FlyingDomotic/Railway-turntable/data/imagePont.png

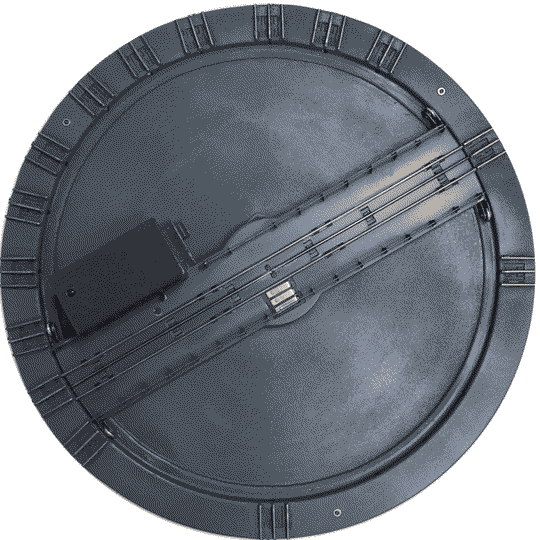
data/imagePont.png
