FlyingDomotic/Railway-turntable/data/plaque.png

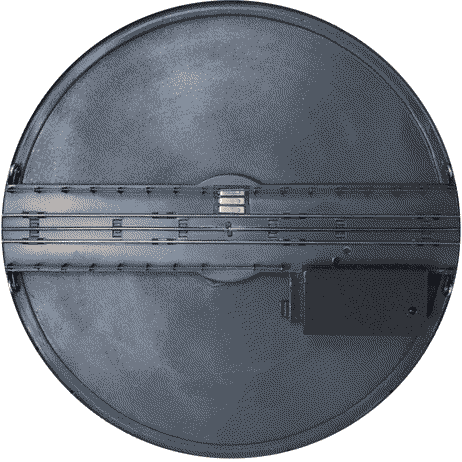
data/plaque.png
