FlyingDomotic/Railway-turntable/Schema.jpg

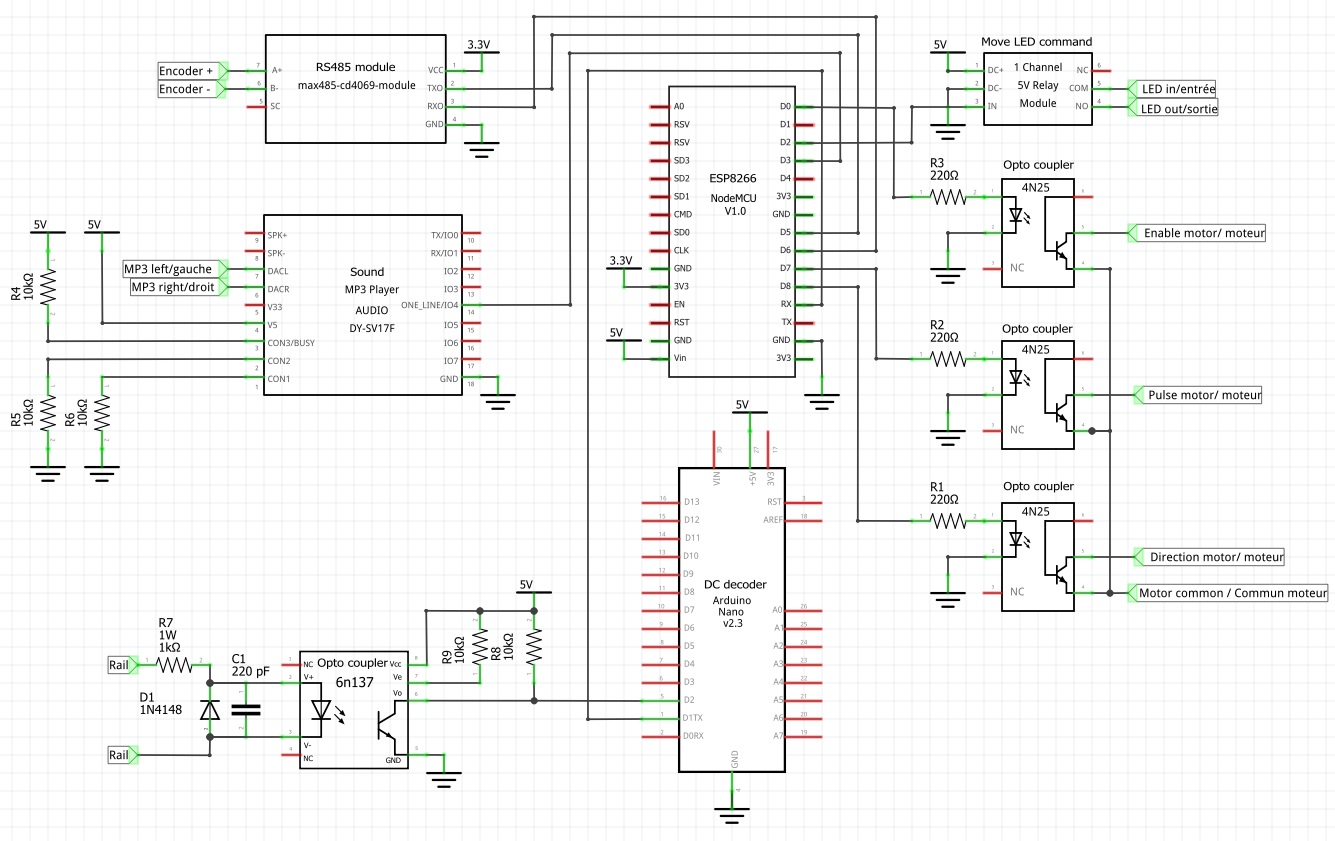
Schema.jpg
