FlyingDomotic/Railway-turntable/src/PontTournant.ino

#define VERSION "24.11.26-1"
/*
 *	   English: Railway turntable control
 *	   Français : Contrôle d'un pont tournant ferroviaire miniature
 *
 *	Hardware
 *		ESP8266
 *		Stepper with driver (enable/pulse/direction) (for example NEMA 24 with DM556T)
 *		RS485 aboslute encoder (for example QY3806-485RTU)
 *		Serial/RS485 adapter
 *		DF-SV17A MP3 player (optional)
 *		Rotation LED (optional)
 *      DCC decoder (optional)
 *
 *	Matériel
 *		ESP8266
 *		Moteur pas à pas avec driver (enable/pulse/direction) (par exemple NEMA 24 avec DM556T)
 *		Encodeur absolu RS485 (par exemple QY3806-485RTU)
 *		Adaptateur série/RS485
 *		Lecteur MP3 DF-SV17A (optionnel)
 *		LED de rotation (optionnel)
 *      Décodeur DCC (optionnel)
 *
 *	Connections
 *		By default, the following pins are defined in preference.h file:
 *          RX (Serial): DCC decoder TX pin
 *			D0 (enablePin): Stepper enable signal
 *			D2 (runPin): Rotation in progress LED pin
 *			D3 (mp3Pin): MP3 one-line pin
 *			D5 (rxPin): RS485 RX pin
 *			D6 (txPin): RS485 TX pin
 *			D7 (pulsePin): Stepper pulse signal
 * 			D8 (directionPin): Stepper direction signal
 *
 *	Connexions
 *		Par défaut, les pinoches suivantes sont définies dans le fichier preference.h :
 *          RX (Serial): Pinoche TX du decoder DCC
 *			D0 (enablePin) : Signal enable du moteur
 *			D2 (runPin) : Pinoche de la LED d'indication de rotation
 *			D3 (mp3Pin) : Pinoche du module MP3 DF-SV17A
 *			D5 (rxPin) : RX du module RS485
 *			D6 (txPin) : TX du module RS485
 *			D7 (pulsePin) : Signal pulse du moteur
 * 			D8 (directionPin) : Signal direction du moteur
 *
 *	Available URL
 *		/			Root page (displays turntable allowing clicking on tracks)
 *		/status		Returns status in JSON format
 *		/goto/<nnn>	Rurns turntable in front of track <nnn> (can be negative to flip direction)
 *		/setup		Display setup page
 *		/edit		Manage and edit flie system
 *		/settings	Returns settings in JSON format
 *		/tstsnd/<x>	Test sound <x>, with 1=before rotation, 2=during rotation and 3=after rotation
 *		/debug		Display internal variables to debug
 *
 * 	URL disponibles
 *		/			Page d'accueil (affiche le pont et permet de cliquer sur les voies)
 *		/status		Retourne l'état sous forme JSON
 *		/goto/<nnn>	Tourne le pont en face de la voie <nnn> (négatif pour retourner la loco)
 *		/setup		Affiche la page de configuration
 *		/edit		Gère et édite le système de fichier
 *		/settings	Retourne la configuration au format JSON
 *		/tstsnd/<x>	Testele son <x>, 1=avant rotation, 2=pendant rotation and 3=après rotation
 *		/debug		Affiche les variables internes pour déverminer
 *
 *	Flying Domotic - Juillet 2024 - For Fablab/Pour le FabLab
 *
 *	GNU GENERAL PUBLIC LICENSE - Version 3, 29 June 2007
 *
 */

#include <ESP8266WiFi.h>											// Wifi
#include <ESPAsyncWebServer.h>										// Asynchronous web server
#include <ArduinoOTA.h>												// OTA (network update)
#include <arduino.h>												// Arduino
#include <preferences.h>											// Turn table preferences
#include <stepperCommand.h>											// Stepper
#include <rotationSensor.h>											// Encoder
#include <mp3_player_module_wire.h>									// DFPlayer mini MP3 player
#include <cmath>													// Math functions
#include <LittleFS.h>												// Flash dile system
#include <littleFsEditor.h>											// LittleFS file system editor
#include <ArduinoJson.h>											// JSON documents

//	---- Variables ----

//	Asynchronous web server
AsyncWebServer webServer(80);										// Web server on port 80
AsyncEventSource events("/events");									// Event root

//	Wifi and module names
String ssid;
String pwd;
String espName = "PontTournant";

//	Preferences file name
#define SETTINGS_FILE "settings.json"

//	Stepper
StepperCommand
	stepper(pulsePin, directionPin, enablePin, traceDebug);			// Setpper class
float lastAngleSent = 0;											// Last sent angle
float currentAngle = 0;												// Current angle
float requiredAngle = -1;											// Required angle
unsigned long rotationStartTime = 0;								// Time of rotation start
unsigned long microStepsToGo = 0;									// Remaining micro steps to send
unsigned long inertiaStepsStarting = 0;								// Number of steps corresponding to inertiaAngleStarting
unsigned long inertiaEndStarting = 0;								// Number of step of end of starting steps (total steps - inertiaStepsStarting)
float normalStepDuration = 0.0;										// Normal (full speed) step duration
float currentStepDuration = 0.0;									// Current (variable) step duration
float inertiaInitialStepDuration = 0.0;								// Duration of step when starting
float inertiaDurationDecrement = 0.0;								// Step duration decrement to add each steps when starting
unsigned long inertiaStepsStopping = 0;								// Number of steps corresponding to inertiaAngleStopping
float inertiaDurationIncrement = 0.0;								// Step duration increment to add each steps when stopping
float inertiaFinalStepDuration = 0.0;								// Duration of step when stopping (will also be used to fix position)
enum stepperState {													// Rotation states
	stepperStopped,
	stepperStarting,
	stepperRunning,
	stepperStopping,
	stepperFixing,
	testingSound
};
stepperState rotationState = stepperStopped;			// Rotation current state
#define MIN_DELTA_ANGLE 0.02							// Minimum delta before sending angle change
const char stepperStateText0[] PROGMEM = "Stopped";
const char stepperStateText1[] PROGMEM = "Starting";
const char stepperStateText2[] PROGMEM = "Running";
const char stepperStateText3[] PROGMEM = "Stopping";
const char stepperStateText4[] PROGMEM = "Fixing";
const char stepperStateText5[] PROGMEM = "TestingSound";
const char *const stepperStateTable[] PROGMEM = {stepperStateText0, stepperStateText1, stepperStateText2, stepperStateText3, stepperStateText4, stepperStateText5};

//	Encoder
RotationSensor encoder(rxPin, txPin, traceDebug);		// Encoder class
uint16_t resultValue;									// Encoder last result
unsigned long resultValueTime = 0;						// Encoder last result time
bool encoderReading = false;							// Is encoder reading?
unsigned long encoderReadTime = 0;						// Save encoder read time
Modbus::ResultCode encoderLastReadError;				// Last error returned by encoder

// MP3 reader
Mp3PlayerModuleWire mp3Player(mp3Pin);					// MP3 module one-line protocol
unsigned long playerStartedTime = 0;					// Last play time
unsigned long playerDuration = 0;						// Play duration time

// DCC decoder
uint16_t lastDccAddress = 0;                            // Last DCC address received
char dccBuffer[15];                                     // Buffer for DCC message xxxxx,xxx,xxx
uint8_t dccBufferPtr = 0;                               // Pointer into DCC buffer

//	---- Print rountines ----

static void printInfo(const char* _format, ...) {
	// Make the message
	char msg[512];                              		// Message buffer (message truncated if longer than this)
	va_list arguments;                                  // Variable argument list
	va_start(arguments, _format);                       // Read arguments after _format
	vsnprintf_P(msg, sizeof(msg), _format, arguments);	// Return buffer containing requested format with given arguments
	va_end(arguments);                                  // End of argument list
	Serial.print(msg);			                        // Print on SERIAL_PORT
	if (traceCode) {
		events.send(msg, "info");						// Send message to destination
	}
}

static void printError(const char* _format, ...) {
	// Make the message
	char msg[512];                              		// Message buffer (message truncated if longer than this)
	va_list arguments;                                  // Variable argument list
	va_start(arguments, _format);                       // Read arguments after _format
	vsnprintf_P(msg, sizeof(msg), _format, arguments);	// Return buffer containing requested format with given arguments
	va_end(arguments);                                  // End of argument list
	Serial.print(msg);			                        // Print on SERIAL_PORT
	events.send(msg, "error");							// Send message to destination
}

//	---- Preferences routines ----

// Dumps all settings on screen
void dumpSettings(void) {
	printInfo("ssid = %s\n", ssid.c_str());
	printInfo("pwd = %s\n", pwd.c_str());
	printInfo("name = %s\n", espName.c_str());
	printInfo("degreesPerStep = %.2f\n", degreesPerStep);
	printInfo("microStepsPerStep = %d\n", microStepsPerStep);
	printInfo("invertStepper = %s\n", invertStepper ? "false" : "true");
	printInfo("stepperReduction = %.2f\n", stepperReduction);
	printInfo("requiredRMP = %.2f\n", requiredRPM);
	printInfo("driverMinimalMicroSec = %d\n", driverMinimalMicroSec);
	printInfo("inertiaAngleStarting = %.2f\n", inertiaAngleStarting);
	printInfo("inertiaAngleStopping = %.2f\n", inertiaAngleStopping);
	printInfo("inertiaFactorStarting = %.2f\n", inertiaFactorStarting);
	printInfo("inertiaFactorStopping = %.2f\n", inertiaFactorStopping);
    printInfo("ledOnWhenHigh = %s\n", ledOnWhenHigh ? "true" : "false");
	printInfo("maxDelta = %d\n", maxDelta);
	printInfo("encoderOffsetAngle = %.2f\n", encoderOffsetAngle);
	printInfo("clockwiseIncrement = %s\n", clockwiseIncrement ? "true" : "false");
	printInfo("imageOffsetAngle = %.2f\n", imageOffsetAngle);
	printInfo("enableCircles = %s\n", enableCircles ? "true" : "false");
	printInfo("slaveId = %d\n", slaveId);
	printInfo("regId = %d\n", regId);
	printInfo("radius = %f\n", radius);
	printInfo("enableSound = %s\n", enableSound ? "true" : "false");
	printInfo("beforeSoundIndex = %d\n", beforeSoundIndex);
	printInfo("beforeSoundDuration = %.2f\n", beforeSoundDuration);
	printInfo("beforeSoundVolume = %d\n", beforeSoundVolume);
	printInfo("moveSoundIndex = %d\n", moveSoundIndex);
	printInfo("moveSoundVolume = %d\n", moveSoundVolume);
	printInfo("afterSoundIndex = %d\n", afterSoundIndex);
	printInfo("afterSoundDuration = %.2f\n", afterSoundDuration);
	printInfo("afterSoundVolume = %d\n", afterSoundVolume);
	printInfo("enableDCC = %s\n", enableDCC ? "true" : "false");
    printInfo("enableReversePosition = %s\n", enableReversePosition ? "true" : "false");
	printInfo("trackCount = %d\n", trackCount);
	printInfo("traceDebug = %s\n", traceDebug ? "true" : "false");
	printInfo("traceCode = %s\n", traceCode ? "true" : "false");
	printInfo("traceJava = %s\n", traceJava ? "true" : "false");

	// Dump all defined angles
	for (uint8_t i = 1; i <= POSITION_COUNT; i++) {
		if (indexes[i] != -1) {
			printInfo("a%d=%.2f", i, indexes[i]);
            // Print DCC addresses if enabled
            if (enableDCC) {
                   printInfo("/%.1f", addresses[i]);
                    if (enableReversePosition) {
                        printInfo("/%.1f", reverses[i]);
                    }
            }
            printInfo(" ");
		}
	}
	printInfo("\n");
}

// Read settings
bool readSettings(void) {
	File settingsFile = LittleFS.open(SETTINGS_FILE, "r");			// Open settings file
	if (!settingsFile) {											// Error opening?
		printError("Failed to open config file\n");
		return false;
	}

	JsonDocument settings;
	auto error = deserializeJson(settings, settingsFile);			// Read settings
	settingsFile.close();											// Close file
	if (error) {													// Error reading JSON?
		printError("Failed to parse config file\n");
		return false;
	}

	// Load all settings into corresponding variables
	degreesPerStep = settings["degreesPerStep"].as<float>();
	if (degreesPerStep <= 0.0) {
		printError("degreesPerStep is %f, should be > 0\n", degreesPerStep);
	}
	microStepsPerStep = settings["microStepsPerStep"].as<uint16_t>();
	if (microStepsPerStep == 0) {
		printError("microStepsPerStep is %d, should be > 0\n", microStepsPerStep);
	}
	invertStepper = settings["invertStepper"].as<bool>();
	stepperReduction = settings["stepperReduction"].as<float>();
	if (stepperReduction <= 0.0) {
		printError("stepperReduction is %f, should be > 0\n", stepperReduction);
	}
	driverMinimalMicroSec =settings["driverMinimalMicroSec"].as<uint16_t>();
	requiredRPM = settings["requiredRPM"].as<float>();
	if (requiredRPM <= 0.0) {
		printError("requiredRPM is %f, should be > 0\n", requiredRPM);
	}
	inertiaAngleStarting = settings["inertiaAngleStarting"].as<float>();
	if (inertiaAngleStarting < 0.0) {
		printError("inertiaAngleStarting is %f, should be >= 0\n", inertiaAngleStarting);
	}
	inertiaAngleStopping = settings["inertiaAngleStopping"].as<float>();
	if (inertiaAngleStopping < 0.0) {
		printError("inertiaAngleStopping is %f, should be >= 0\n", inertiaAngleStopping);
	}
	inertiaFactorStarting = settings["inertiaFactorStarting"].as<float>();
	if (inertiaFactorStarting < 1.0) {
		printError("inertiaFactorStarting is %f, should be >= 1\n", inertiaFactorStarting);
	}
	inertiaFactorStopping = settings["inertiaFactorStopping"].as<float>();
	if (inertiaFactorStopping < 1.0) {
		printError("inertiaFactorStopping is %f, should be >= 1\n", inertiaFactorStopping);
	}
	maxDelta = settings["maxDelta"].as<uint8_t>();
	enableEncoder = settings["enableEncoder"].as<bool>();
	adjustPosition = settings["adjustPosition"].as<bool>();
	encoderOffsetAngle = settings["encoderOffsetAngle"].as<float>();
	clockwiseIncrement = settings["clockwiseIncrement"].as<bool>();
	imageOffsetAngle = settings["imageOffsetAngle"].as<float>();
	slaveId = settings["slaveId"].as<uint8_t>();
	regId = settings["regId"].as<uint8_t>();
	radius = settings["radius"].as<float>();
	trackCount = settings["trackCount"].as<uint8_t>();
	traceDebug = settings["traceDebug"].as<bool>();
	traceCode = settings["traceCode"].as<bool>();
	traceJava = settings["traceJava"].as<bool>();
    ledOnWhenHigh = settings["ledOnWhenHigh"].as<bool>();
	ssid = settings["ssid"].as<String>();
	pwd = settings["pwd"].as<String>();
	espName = settings["name"].as<String>();
	enableSound = settings["enableSound"].as<bool>();
	enableCircles = settings["enableCircles"].as<bool>();
	enableDCC = settings["enableDCC"].as<bool>();
	enableReversePosition = settings["enableReversePosition"].as<bool>();
	beforeSoundIndex = settings["beforeSoundIndex"].as<uint16_t>();
	beforeSoundDuration = settings["beforeSoundDuration"].as<float>();
	beforeSoundVolume = settings["beforeSoundVolume"].as<uint8_t>();
	moveSoundIndex = settings["moveSoundIndex"].as<uint16_t>();
	moveSoundVolume = settings["moveSoundVolume"].as<uint8_t>();
	afterSoundIndex = settings["afterSoundIndex"].as<uint16_t>();
	afterSoundDuration = settings["afterSoundDuration"].as<float>();
    afterSoundVolume = settings["afterSoundVolume"].as<uint8_t>();

	// Read "axx" and "dxx" variables into a table
	char name[10];
	for (uint8_t i = 1; i <= POSITION_COUNT; i++) {
		snprintf(name, sizeof(name), "a%d", i);
		indexes[i] = settings[name].as<float>();
		snprintf(name, sizeof(name), "d%d", i);
		addresses[i] = settings[name].as<float>();
		snprintf(name, sizeof(name), "r%d", i);
		reverses[i] = settings[name].as<float>();
	}
	// Dump settings on screen
	dumpSettings();
	// Send values to stepper and encoder
	stepper.setParams(degreesPerStep, microStepsPerStep, stepperReduction, invertStepper, driverMinimalMicroSec, requiredRPM, traceDebug);
	encoder.setParams(encoderOffsetAngle, clockwiseIncrement, traceDebug);
	return true;
}

// Write settings
void writeSettings(void) {
	JsonDocument settings;
	char name[10];

	// Load settings in JSON
	settings["ssid"] = ssid.c_str();
	settings["pwd"] = pwd.c_str();
	settings["name"] = espName.c_str();
	settings["degreesPerStep"] = degreesPerStep;
	settings["microStepsPerStep"] = microStepsPerStep;
	settings["driverMinimalMicroSec"] = driverMinimalMicroSec;
	settings["invertStepper"] = invertStepper;
	settings["stepperReduction"] = stepperReduction;
	settings["requiredRPM"] = requiredRPM;
	settings["inertiaAngleStarting"] = inertiaAngleStarting;
	settings["inertiaAngleStopping"] = inertiaAngleStopping;
	settings["inertiaFactorStarting"] = inertiaFactorStarting;
	settings["inertiaFactorStopping"] = inertiaFactorStopping;
    settings["ledOnWhenHigh"] = ledOnWhenHigh;
	settings["maxDelta"] = maxDelta;
	settings["enableEncoder"] = enableEncoder;
	settings["adjustPosition"] = adjustPosition;
	settings["encoderOffsetAngle"] = encoderOffsetAngle;
	settings["clockwiseIncrement"] = clockwiseIncrement;
	settings["imageOffsetAngle"] = imageOffsetAngle;
	settings["slaveId"] = slaveId;
	settings["regId"] = regId;
	settings["radius"] = radius;
	settings["enableDCC"] = enableDCC;
	settings["enableReversePosition"] = enableReversePosition;
	settings["enableSound"] = enableSound;
	settings["beforeSoundIndex"] = beforeSoundIndex;
	settings["beforeSoundDuration"] = beforeSoundDuration;
	settings["beforeSoundVolume"] = beforeSoundVolume;
	settings["moveSoundIndex"] = moveSoundIndex;
	settings["moveSoundVolume"] = moveSoundVolume;
	settings["afterSoundIndex"] = afterSoundIndex;
	settings["afterSoundDuration"] = afterSoundDuration;
	settings["afterSoundVolume"] = afterSoundVolume;
	settings["traceDebug"] = traceDebug;
	settings["traceCode"] = traceCode;
	settings["traceJava"] = traceJava;
	settings["trackCount"] = trackCount;
	// Load all "axx" and "dxx" variables
	for (uint8_t i = 1; i <= POSITION_COUNT; i++) {
		snprintf(name, sizeof(name), "a%d", i);
		settings[name] = indexes[i];
		snprintf(name, sizeof(name), "d%d", i);
		settings[name] = addresses[i];
		snprintf(name, sizeof(name), "r%d", i);
		settings[name] = reverses[i];
	}

	File settingsFile = LittleFS.open(SETTINGS_FILE, "w");			// Open settings file
	if (!settingsFile) {											// Error opening?
		printError("Can't open for write settings file\n");
	}
	uint16_t bytes = serializeJsonPretty(settings, settingsFile);	// Write JSON structure to file
	if (!bytes) {													// Error writting?
		printError("Can't write settings file\n");
	}
	settingsFile.flush();											// Flush file
	settingsFile.close();											// Close it
	// Reload variables into stepper, encoder and player
	stepper.setParams(degreesPerStep, microStepsPerStep, stepperReduction, invertStepper, driverMinimalMicroSec, requiredRPM, traceDebug);
	encoder.setParams(encoderOffsetAngle, clockwiseIncrement, traceDebug);
	if (traceCode) {
		printInfo("Sending settings event\n");
	}
	events.send("Ok", "settings");									// Send a "settings" (changed) event
}

//	---- Encoder routines ----

// called at end of Modbus transaction
Modbus::ResultCode modbusCb(Modbus::ResultCode event, uint16_t transactionId, void* data) {
	if (event != encoderLastReadError) {							// Is return code different of last one?
	printError("Read error is now: 0x%x\n", event);
	encoderLastReadError = event;
	}
	if (event == Modbus::EX_SUCCESS) {								// We read succesfully
		currentAngle = encoder.computeAngle(resultValue);			// Load current angle from last result
		encoderReading = false;										// Encoder is not anymore reading
	}
	return Modbus::EX_SUCCESS;
}

//	---- Stepper routines ----

// Called at rotation begining
void startRotation(void) {
	digitalWrite(runPin, ledOnWhenHigh ? HIGH : LOW);				// Set rotation pin to ON
	if (rotationState == stepperStopped) {							// Are we stopped?
        computeInertia();											// Compute inertia parameters
        currentStepDuration = inertiaInitialStepDuration;			// Set initial step duration
        inertiaEndStarting = microStepsToGo - inertiaStepsStarting;	// Set number of microsteps correponding to end of starting phase
        printInfo("Moving %ld microsteps, %ld (up to %ld) at %.2fms-%.2fms, normal at %.2fms, %ld stop +%.2fms to %.2fms\n",
            microStepsToGo, 
            inertiaStepsStarting, inertiaEndStarting, currentStepDuration * 1000.0, inertiaDurationDecrement * 1000.0,
            normalStepDuration * 1000.0,
            inertiaStepsStopping, inertiaDurationIncrement * 1000.0, inertiaFinalStepDuration * 1000.0);
		rotationState = stepperRunning;									// Set to running by default
		rotationStartTime = millis();									// Set start rotation time
		if (beforeSoundIndex) {											// Do we have a starting sound?
			rotationState = stepperStarting;							// Set to starting
			playerDuration = beforeSoundDuration * 1000;				// Convert duration to ms
			playIndex(beforeSoundIndex, beforeSoundVolume);				// Play sound
		} else {
			if (moveSoundIndex) {										// Do we have a rotation sound?
				playIndex(moveSoundIndex, moveSoundVolume);				// Play sound
			} else {
				playStop();												// Stop starting sound
			}
		}
	} else if (rotationState == stepperStopping) {						// Are we stopping?
		rotationState = stepperRunning;									// Set to running again
		if (moveSoundIndex) {											// Do we have a rotation sound?
			playIndex(moveSoundIndex, moveSoundVolume);					// Play sound
		}
	
	} else {
		// Put here action you may want when starting a new rotation while turntable is already moving
		// By default, new target is set without stopping rotation, nor playing ending and starting sound
		// If rotation direction is changed, turntable will hardly turn in reverse direction
		printInfo("Received startRotation while moving\n");
	}
}

// Called at rotation end
void stopRotation(void) {
	printInfo("Stopping rotation after %.1fs\n", (millis() - rotationStartTime) / 1000.0);
	if (afterSoundIndex) {											// Do we have a stop sound?
		rotationState = stepperStopping;							// Set to stopping
		playerDuration = afterSoundDuration * 1000;					// Convert duration in ms
		playIndex(afterSoundIndex, afterSoundVolume);				// Play stopping sound
		return;
	}
	playStop();														// Stop running sound
	rotationState = stepperStopped;									// Force to stopped
	digitalWrite(runPin, ledOnWhenHigh ? LOW: HIGH);				// Set rotation pin to OFF
}

// Move turntable to a given track
void moveToTrack(uint8_t index) {
    if (index < 0) {                                                // Is index negative?
	    requiredAngle = indexes[-index] + 180.0;					// Opposite of user's required angle
        if (requiredAngle >= 360.0) {                               // Make angle in range 0-360
            requiredAngle -= 360.0;
        }
    } else {
	    requiredAngle = indexes[index];								// User's required angle
    }
    float deltaAngle = requiredAngle - currentAngle;				// Difference to move
	if (deltaAngle > 180.0) {										// Set angle into -180/+180 range
		deltaAngle -= 360.0;
	}
	if (deltaAngle < -180.0) {
		deltaAngle += 360.0;
	}
	microStepsToGo = stepper.microStepsForAngle(deltaAngle);		// Compute micro steps to move
	if (traceCode) {
		printInfo("Current angle %.2f, required %.2f, delta %.2f, %ld microsteps, %.2f°/microstep\n", currentAngle, requiredAngle, deltaAngle, microStepsToGo, stepper.anglePerMicroStep());
	}
	if (microStepsToGo) {											// Do we have to move?
		startRotation();											// Start rotation phase
	}
}

// Ajdust stepper position if required (to be called when stepper is not running, after currentAngle set by encoder)
void fixPosition(void){
	if (adjustPosition && rotationState == stepperStopped) {		// Only if position adjustment is required and stepper stopped
		if (requiredAngle != -1) {									// Don't adjust position after manual move (no required angle)
			float deltaAngle = requiredAngle - currentAngle;		// Difference to move
			if (deltaAngle > 180.0) {								// Set angle into -180/+180 range
				deltaAngle -= 360.0;
			}
			if (deltaAngle < -80.0) {
				deltaAngle += 360.0;
			}
			microStepsToGo = stepper.microStepsForAngle(deltaAngle);// Compute micro steps to move
			if (microStepsToGo) {									// Do we have to move?
				rotationState = stepperFixing;						// Set proper state
                currentStepDuration = normalStepDuration;           // At normal speed
				if (traceCode) {
					printInfo("Fix: Current angle = %.2f, required angle = %.2f, delta angle = %.2f, micro step count = %ld, angle per micro step = %.2f\n", currentAngle, requiredAngle, deltaAngle, microStepsToGo, stepper.anglePerMicroStep());
				}
			}
		}
	}
}

void computeInertia() {
	inertiaStepsStarting = 0;									// Number of steps corresponding to inertiaAngleStarting
	inertiaInitialStepDuration = 0.0;							// Duration of step when starting
	inertiaDurationDecrement = 0.0;								// Step duration decrement to add each steps when starting
	inertiaStepsStopping = 0;									// Number of steps correspinding to inertiaAngleStopping
	inertiaDurationIncrement = 0.0;								// Step duration increment to add each steps when stopping
	inertiaFinalStepDuration = 0.0;								// Duration of step when stopping (will also be used to fix position)

	normalStepDuration = stepper.getStepDuration();				// Get step duration
	
	if (inertiaAngleStarting > 0.0 && inertiaFactorStarting > 1.0) {										// Do we have to add starting inertia?
		inertiaStepsStarting = stepper.microStepsForAngle(inertiaAngleStarting, false);						// Number of steps to turn of starting angle
		inertiaInitialStepDuration = normalStepDuration * inertiaFactorStarting;							// Step duration at startup
		inertiaDurationDecrement = (inertiaInitialStepDuration - normalStepDuration) / inertiaStepsStarting;//Decrement of duration of each step when starting
	}

	if (inertiaAngleStopping > 0.0 && inertiaFactorStopping > 1.0) {										// Do we have to add stopping inertia?
		inertiaStepsStopping = stepper.microStepsForAngle(inertiaAngleStopping, false);						// Number of steps to turn of stopping angle
		inertiaFinalStepDuration = normalStepDuration * inertiaFactorStopping;								// Step duration at startup
		inertiaDurationIncrement = (inertiaFinalStepDuration - normalStepDuration) / inertiaStepsStopping;	//Increment of duration of each step when stopping
	}

	/*
	if (traceCode) {
		printInfo("Steps %.2f ms, %ld start %.2f ms-%.2f ms, %ld stop to %.2f ms+%.2f ms\n",
			normalStepDuration * 1000.0,
			inertiaStepsStarting, inertiaInitialStepDuration * 1000.0, inertiaDurationDecrement * 1000.0,
			inertiaStepsStopping, inertiaFinalStepDuration * 1000.0, inertiaDurationIncrement * 1000.0);
	}
	*/
}

//	---- MP3 player routines ----

// Play a given index
void playIndex(int index, uint8_t soundVolume) {
	if (enableSound) {												// If sound enabled
		/*
		if (traceCode) {
			printInfo("Playing file %d, level %d\n", index, soundVolume);
		}
		*/
		playerStartedTime = millis();								// Load starting time
        mp3Player.set_volume(soundVolume);							// Set volume
		mp3Player.set_track_index(index);                           // Set file index
        mp3Player.play();											// Start playing file
	}
}

// Stop playing
void playStop() {
	if (enableSound) {												// If sound enabled
		/*
		if (traceCode) {
			printInfo("Stop playing\n");
		}
		*/
		mp3Player.stop();
	}
}

//  ---- DCC routines ----

void checkForDccMessage(void) {
    // Are some characters from DCC controller available?
    if (Serial.available()) {
        // Read all available characters
		while (Serial.available()) {
			// Read one char
            char c = Serial.read();
			// Is this end of line?
			if (c == 10 or c == 13) {
                if (dccBufferPtr) {
                    unsigned int addr = 0;
                    unsigned int direction = 0;
                    unsigned int outputPower = 0;
                    int result = sscanf(dccBuffer, "%u %u %u", &addr, &direction, &outputPower);
                    if (result == 3) {
                        notifyDccAccTurnoutOutput(addr, direction, outputPower);
                        // Clear DCC buffer
                        dccBufferPtr = 0;
                        memset(dccBuffer, 0 ,sizeof(dccBuffer));
                    } else {
                        printError("Can't decode >%s< as DCC message\n", dccBuffer);
                        // Clear DCC buffer
                        dccBufferPtr = 0;
                        memset(dccBuffer, 0 ,sizeof(dccBuffer));
                    }
                }
            // Else store character, skipping NULL
			} else if (c) {
                // Is some room in dccBuffer?
                if (dccBufferPtr < sizeof(dccBuffer)) {
                    dccBuffer[dccBufferPtr++] = c;      // Copy received character
                    dccBuffer[dccBufferPtr] = 0;        // Add a trailing zero
				} else {
                    // Buffer is full, reset it
                    printError("DCC buffer overflow, ignoring %s\n", dccBuffer);
                    dccBufferPtr = 0;
                    memset(dccBuffer, 0 ,sizeof(dccBuffer));
                }
            }
        }
    }
}

// This function is called whenever a normal DCC Turnout Packet is received
void notifyDccAccTurnoutOutput(unsigned int addr, unsigned int direction, unsigned int outputPower) {
    //printInfo("DccAccTurnoutBoard addr=%d, direction=%d, outputPower=%x\n", addr, direction, outputPower);
    // Define received address
    uint16_t address = (addr * 10) + (direction * 5);
    if (address != lastDccAddress) {
        // Save last DCC address as multiple messages will be received, and remaining to be ignored
        lastDccAddress = address;
        printInfo("DCC address %.1f received\n", float(address) / 10.0);
        // Scan all DCC addresses
        for (uint8_t track=1; track <= POSITION_COUNT; track++) {
            // Convert float DCC address to integer
            uint16_t dccAddress = addresses[track] * 10;
            //printInfo("Index %d=%d\n", track, dccAddress);
            if (dccAddress == address) {
                printInfo("Turning to track #%d\n", track);
                // Verify range of track number to amazing side effects
                if (track >0 && track <= trackCount)  {
                    // Move to given track
                    moveToTrack(track);
                    return;
                }
            }
        }
        // Scan all DCC reverse addresses
        for (uint8_t track=1; track <= POSITION_COUNT; track++) {
            // Convert float DCC reverse address to integer
            uint16_t dccReverseAddress = reverses[track] * 10;
            //printInfo("Index %d=%d\n", track, dccReverseAddress);
            if (dccReverseAddress == address) {
                printInfo("Turning reversed to track #%d\n", track);
                // Verify range of track number to amazing side effects
                if (track >0 && track <= trackCount)  {
                    // Move to given track
                    moveToTrack(-track);
                    return;
                }
            }
        }
    }
}

//	---- Web server routines ----

// Called when /setup is received
void setupReceived(AsyncWebServerRequest *request) {
	AsyncWebServerResponse *response = request->beginResponse(LittleFS, "setup.htm", "text/html");
	request->send(response);										// Send setup.htm
}

// Called when /settings is received
void settingsReceived(AsyncWebServerRequest *request) {
	AsyncWebServerResponse *response = request->beginResponse(LittleFS, SETTINGS_FILE, "application/json");
	request->send(response);										// Send settings.json
}

// Called when /debug is received
void debugReceived(AsyncWebServerRequest *request) {
	// Send a json document with interresting variables
	JsonDocument answer;
	char text[30];
	answer["lastAngleSent"] = lastAngleSent;
	answer["currentAngle"] = currentAngle;
	answer["requiredAngle"] = requiredAngle;
	answer["microStepsToGo"] = microStepsToGo;
	answer["rotationState"] = rotationState;
	if (rotationState < 0 || rotationState >= sizeof(stepperStateTable)) {
		snprintf_P(text, sizeof(text), PSTR("??? %d ???"), rotationState);
	} else {
		strncpy_P(text, (char *)pgm_read_ptr(&(stepperStateTable[rotationState])), sizeof(text));
	}
	answer["rotationStateText"] = text;
	answer["encoderReading"] = encoderReading;
	answer["encoderReadTime"] = millis() - encoderReadTime;
	answer["encoderLastReadError"] = encoderLastReadError;
	answer["resultValue"] = resultValue;
	answer["resultValueTime"] = millis() - resultValueTime;
	answer["playerStartedTime"] = millis() - playerStartedTime;
	answer["playerDuration"] = playerDuration;
	char buffer[1024];
	serializeJsonPretty(answer, buffer, sizeof(buffer));
	request->send(200, "application/json", String(buffer));
}

// Called when a /status click is received
void statusReceived(AsyncWebServerRequest *request) {
	// Send a json document with data correponding to current position
	float closestDelta = 999.0;
	float closestTrack = -1;
	// Loop through all used tracks
	for (uint8_t i = 1; i <= trackCount; i++) {
		float delta = currentAngle - indexes[i];					// Compute delta between current angle and track given angle
		if (delta < 0.0) {
			delta = - delta;										// Make it positive
		}
		if (delta < closestDelta) {									// Closer than closest?
			closestDelta = delta;									// Load closest delta
			closestTrack = i;										//   and track
		}
	}
	JsonDocument answer;
	char text[30];
	if (rotationState < 0 || rotationState >= sizeof(stepperStateTable)) {
		snprintf_P(text, sizeof(text), PSTR("??? %d ???"), rotationState);
	} else {
		strncpy_P(text, (char *)pgm_read_ptr(&(stepperStateTable[rotationState])), sizeof(text));
	}
	answer["rotationState"] = text;
	answer["currentAngle"] = currentAngle;
	answer["requiredAngle"] = requiredAngle;
	answer["closestTrack"] = closestTrack;
	answer["closestDelta"] = closestDelta;
	char buffer[1024];
	serializeJsonPretty(answer, buffer, sizeof(buffer));
	request->send(200, "application/json", String(buffer));
}

// Called when a /pos/<x_percent>/<y_percent> click is received
void clickReceived(AsyncWebServerRequest *request) {
	String position = request->url().substring(1);
	if (traceCode) {
		printInfo("Received %s\n", position.c_str());
	}
	// Try to locate closest track from clicked image
	int8_t closestIndex = -1;										// Init closest track index

	int separator1 = position.indexOf("/");							// Position of first "/"
	if (separator1 >= 0) {
		int separator2 = position.indexOf("/", separator1+1); 		// Position of second "/"
		if (separator2 > 0) {
			// Extract x and y values from request
			float x = position.substring(separator1+1, separator2).toFloat();
			float y = position.substring(separator2+1).toFloat();
            float closestDistance = 9999.0;
			// Loop through all used tracks
			for (uint8_t i = 1; i <= trackCount; i++) {
				// Compute track x/y percentage given angle
				float xPos = 50.0 + (radius * cos(indexes[i] * PI / 180.0));
				float yPos = 50.0 - (radius * sin(indexes[i] * PI / 180.0));
				// Test difference against max delta
				if (abs(x - xPos) < maxDelta and abs(y - yPos) < maxDelta) {
					// Compute distance
					float distance = sqrt(pow(abs(x - xPos), 2) + pow(abs(y - yPos), 2));
					// If distance is shorter than previous one, save index and distance
					if (distance < closestDistance) {
						closestDistance = distance;
						closestIndex = i;
					}
				}
			}
			if (traceCode) {
				printInfo("Move to index: %d\n", closestIndex);
			}
			// Turn table to closest index, if found
			if (closestIndex >=0) {
				moveToTrack(closestIndex);
			}
		}
	}
	request->send_P(200, "", "<status>Ok</status>");
}

// Called when /move/<micro step count> received
void moveReceived(AsyncWebServerRequest *request) {
	char msg[70];                                                       // Buffer for message

	String position = request->url().substring(1);
	if (traceCode) {
		printInfo("Received %s\n", position.c_str());
	}
	int separator1 = position.indexOf("/");								// Position of first "/"
	if (separator1 >= 0) {
        if (rotationState == stepperStopped) {		                    // Only if stepper stopped
            // Extract micro step (signed) count and move
            int16_t count = position.substring(separator1+1).toInt();
            requiredAngle = -1;                                         // Force to -1 to disable fixing after move
            stepper.setDirection(count);
            microStepsToGo = abs(count);
            rotationState = stepperFixing;
            currentStepDuration = normalStepDuration;           // At normal speed
            snprintf(msg, sizeof(msg),"<status>Ok, moving %d micro steps</status>", count);
            request->send_P(200, "", msg);
        } else {
            snprintf(msg, sizeof(msg),"<status>Can't move while stepper is not stopped</status>");
            request->send_P(400, "", msg);
        }
        return;
	}

	snprintf(msg, sizeof(msg),"<status>Can't understand %s</status>", request->url().c_str());
	request->send_P(400, "", msg);
}

// Called when /imgref is received
void imgRefReceived(AsyncWebServerRequest *request) {
	String position = request->url().substring(1);
	if (traceCode) {
		printInfo("Received %s\n", position.c_str());
	}
	// Set image offset (difference with current version)
	imageOffsetAngle = encoder.floatModuloPositive(imageOffsetAngle - currentAngle, 360.0);
	writeSettings();
	moveToTrack(1);			// As we moved image, we moved turntable. Move it back to zero.
	request->send_P(200, "", "<status>Ok</status>");
}

// Called when /goto/<track number> is received
void gotoReceived(AsyncWebServerRequest *request) {
	String position = request->url().substring(1);
	if (traceCode) {
		printInfo("Received %s\n", position.c_str());
	}
	int separator1 = position.indexOf("/");							// Position of first "/"
	if (separator1 >= 0) {
		// Extract track number to move to
		int8_t track = position.substring(separator1+1).toInt();
		// Check for track limits (as users can send this request)
		if ((track > 0 && track <= trackCount) || (enableReversePosition && (track < 0) && ( track >= -trackCount)))  {
			moveToTrack(track);										// Move to given track
			char msg[50];											// Buffer for message
			snprintf(msg, sizeof(msg),"<status>Ok, going to track %d</status>", track);
			request->send_P(200, "", msg);
			return;
        }
		char msg[70];											// Buffer for message
        if (enableReversePosition) {
		    snprintf(msg, sizeof(msg),"<status>Bad track number %d, should be (+/-) 1-%d</status>", track, trackCount);
        } else {
		    snprintf(msg, sizeof(msg),"<status>Bad track number %d, should be 1-%d</status>", track, trackCount);
        }
		request->send_P(400, "", msg);
		return;
	}
	char msg[50];											// Buffer for message
	snprintf(msg, sizeof(msg),"<status>Can't understand %s</status>", request->url().c_str());
	request->send_P(400, "", msg);
}

// Called when /setangle/<track number> is received
void setAngleReceived(AsyncWebServerRequest *request) {
	String position = request->url().substring(1);
	if (traceCode) {
		printInfo("Received %s\n", position.c_str());
	}
	int separator1 = position.indexOf("/");							// Position of first "/"
	if (separator1 >= 0) {
		// Extract track number
		int8_t track = position.substring(separator1+1).toInt();
		if (track == 1) {											// Special case of first track
			indexes[1] = 0.0;										// Angle is zero
			encoderOffsetAngle = encoder.floatModuloPositive(
					encoderOffsetAngle + currentAngle, 360.0);		// Set encoder offset
			writeSettings();
		} else {
			// Check for track limits (as users can send this request)
			if (track > 0 && track <= trackCount)  {
				indexes[track] = currentAngle;						// Set current angle to track
				writeSettings();
				request->send_P(200, "", "<status>Ok</status>");
				return;
			}
			char msg[70];											// Buffer for message
			snprintf(msg, sizeof(msg),"<status>Bad track number %d, should be 1-%d</status>", track, trackCount);
			request->send_P(400, "", msg);
			return;
		}
	}
	char msg[70];											// Buffer for message
	snprintf(msg, sizeof(msg),"<status>Can't understand %s</status>", request->url().c_str());
	request->send_P(400, "", msg);
}

// Called when /setangle/<track number> is received
void testSoundReceived(AsyncWebServerRequest *request) {
	String position = request->url().substring(1);
	if (traceCode) {
		printInfo("Received %s\n", position.c_str());
	}
	int separator1 = position.indexOf("/");							// Position of first "/"
	if (separator1 >= 0) {
		// Extract index number
		int8_t index = position.substring(separator1+1).toInt();
		if (rotationState == stepperStopped) {
			if (enableSound) {
				if (index == 1) {											// Index = 1
					if (beforeSoundIndex) {
						rotationState = testingSound;						// Set to starting
						playerDuration = beforeSoundDuration * 1000;		// Convert duration to ms
						playIndex(beforeSoundIndex, beforeSoundVolume);		// Play sound
						request->send_P(200, "", "<status>Ok</status>");
					} else {
						char msg[50];										// Buffer for message
						snprintf(msg, sizeof(msg),"<status>Before sound index not defined</status>");
						request->send_P(400, "", msg);
						return;
					}
				} else if (index == 2) {									// Index = 2
					if (moveSoundIndex) {
						rotationState = testingSound;						// Set to starting
						playerDuration = 5 * 1000;							// Convert duration to ms
						playIndex(moveSoundIndex, moveSoundVolume);			// Play sound
						request->send_P(200, "", "<status>Ok</status>");
					} else {
						char msg[50];										// Buffer for message
						snprintf(msg, sizeof(msg),"<status>Moving sound index not defined</status>");
						request->send_P(400, "", msg);
						return;
					}
				} else if (index == 3) {									// Index = 3
					if (afterSoundIndex) {
						rotationState = testingSound;						// Set to starting
						playerDuration = afterSoundDuration * 1000;			// Convert duration to ms
						playIndex(afterSoundIndex, afterSoundVolume);		// Play sound
						request->send_P(200, "", "<status>Ok</status>");
					} else {
						char msg[50];										// Buffer for message
						snprintf(msg, sizeof(msg),"<status>After sound index not defined</status>");
						request->send_P(400, "", msg);
						return;
					}
				} else {
					char msg[70];											// Buffer for message
					snprintf(msg, sizeof(msg),"<status>Bad index number %d, should be 1-3</status>", index);
					request->send_P(400, "", msg);
					return;
				}
			} else {
				char msg[50];												// Buffer for message
				snprintf(msg, sizeof(msg),"<status>Sound disabled</status>");
				request->send_P(400, "", msg);
				return;
			}
		} else {
			char text[30];
			if (rotationState < 0 || rotationState >= sizeof(stepperStateTable)) {
				snprintf_P(text, sizeof(text), PSTR("??? %d ???"), rotationState);
			} else {
				strncpy_P(text, (char *)pgm_read_ptr(&(stepperStateTable[rotationState])), sizeof(text));
			}
			char msg[80];													// Buffer for message
			snprintf(msg, sizeof(msg),"<status>Stepper not stopped but %s</status>", text);
			request->send_P(400, "", msg);
			return;
		}
	}
	char msg[70];															// Buffer for message
	snprintf(msg, sizeof(msg),"<status>Can't understand %s</status>", request->url().c_str());
	request->send_P(400, "", msg);
}

// Called when /changed/<variable name>/<variable value> is received
void setChangedReceived(AsyncWebServerRequest *request) {
	String position = request->url().substring(1);
	if (traceCode) {
		printInfo("Received %s\n", position.c_str());
	}
	int separator1 = position.indexOf("/");							// Position of first "/"
	if (separator1 >= 0) {
		int separator2 = position.indexOf("/", separator1+1); 		// Position of second "/"
		if (separator2 > 0) {
			// Extract field name and value
			String fieldName = position.substring(separator1+1, separator2);
			String fieldValue = position.substring(separator2+1);
			fieldValue.toLowerCase();
			// Check against known field names and set value accordingly
			if (fieldName == "trackCount") {
				trackCount = fieldValue.toInt();
			} else if (fieldName == "degreesPerStep") {
				degreesPerStep = fieldValue.toFloat();
			} else if (fieldName == "microStepsPerStep") {
				microStepsPerStep = fieldValue.toInt();
			} else if (fieldName == "invertStepper") {
				invertStepper = (fieldValue == "true");
			} else if (fieldName == "stepperReduction") {
				stepperReduction = fieldValue.toFloat();
			} else if (fieldName == "clockwiseIncrement") {
				clockwiseIncrement = (fieldValue == "true");
			} else if (fieldName == "driverMinimalMicroSec") {
				driverMinimalMicroSec = fieldValue.toInt();
			} else if (fieldName == "requiredRPM") {
				requiredRPM = fieldValue.toFloat();
			} else if (fieldName == "inertiaAngleStarting") {
				inertiaAngleStarting = fieldValue.toFloat();
			} else if (fieldName == "inertiaAngleStopping") {
				inertiaAngleStopping = fieldValue.toFloat();
			} else if (fieldName == "inertiaFactorStarting") {
				inertiaFactorStarting = fieldValue.toFloat();
			} else if (fieldName == "inertiaFactorStopping") {
				inertiaFactorStopping = fieldValue.toFloat();
			} else if (fieldName == "ledOnWhenHigh") {
				ledOnWhenHigh = (fieldValue == "true");
			} else if (fieldName == "slaveId") {
				slaveId = fieldValue.toInt();
			} else if (fieldName == "regId") {
				regId = fieldValue.toInt();
			} else if (fieldName == "radius") {
				radius = fieldValue.toFloat();
			} else if (fieldName == "maxDelta") {
				maxDelta = fieldValue.toInt();
			} else if (fieldName == "traceDebug") {
				traceDebug = (fieldValue == "true");
			} else if (fieldName == "traceCode") {
				traceCode = (fieldValue == "true");
			} else if (fieldName == "traceJava") {
				traceJava = (fieldValue == "true");
			} else if (fieldName == "ssid") {
				ssid = fieldValue;
			} else if (fieldName == "pwd") {
				pwd = fieldValue;
			} else if (fieldName == "name") {
				espName = fieldValue;
			} else if (fieldName == "enableEncoder") {
				enableEncoder = (fieldValue == "true");
			} else if (fieldName == "adjustPosition") {
				adjustPosition = (fieldValue == "true");
			} else if (fieldName == "enableDCC") {
				enableDCC = (fieldValue == "true");
			} else if (fieldName == "enableReversePosition") {
				enableReversePosition = (fieldValue == "true");
			} else if (fieldName == "enableSound") {
				enableSound = (fieldValue == "true");
			} else if (fieldName == "beforeSoundIndex") {
				beforeSoundIndex = fieldValue.toInt();
			} else if (fieldName == "beforeSoundDuration") {
				beforeSoundDuration = fieldValue.toFloat();
			} else if (fieldName == "beforeSoundVolume") {
				beforeSoundVolume = fieldValue.toInt();
			} else if (fieldName == "moveSoundIndex") {
				moveSoundIndex = fieldValue.toInt();
			} else if (fieldName == "moveSoundVolume") {
				moveSoundVolume = fieldValue.toInt();
			} else if (fieldName == "afterSoundIndex") {
				afterSoundIndex = fieldValue.toInt();
			} else if (fieldName == "afterSoundDuration") {
				afterSoundDuration = fieldValue.toFloat();
			} else if (fieldName == "afterSoundVolume") {
				afterSoundVolume = fieldValue.toInt();
            } else if (fieldName.startsWith("d") and fieldName.length() <= 3) {
                // This is a "dxx" field, extract index and set value
                unsigned fieldIndex = fieldName.substring(2).toInt();
                addresses[fieldIndex] = fieldValue.toFloat();
            } else if (fieldName.startsWith("r") and fieldName.length() <= 3) {
                // This is a "rxx" field, extract index and set value
                unsigned fieldIndex = fieldName.substring(2).toInt();
                reverses[fieldIndex] = fieldValue.toFloat();
            } else {
				// This is not a known field
				printError("Can't set field %s\n", fieldName.c_str());
				char msg[70];											// Buffer for message
				snprintf(msg, sizeof(msg),"<status>Bad field name %s</status>", fieldName.c_str());
				request->send_P(400, "", msg);
				return;
			}
			writeSettings();
		}
	}
	request->send_P(200, "", "<status>Ok</status>");
}

// Sends a 404 error with requested file name
void send404Error(AsyncWebServerRequest *request) {
	char msg[70];
	snprintf_P(msg, sizeof(msg), PSTR("File %s not found"), request->url().c_str());
	request->send(404, "text/plain", msg);
	if (traceCode) {
		Serial.println(msg);
	}
}

// Called when a request can't be mapped to existing ones
void notFound(AsyncWebServerRequest *request) {
	send404Error(request);
}

//	---- OTA routines ----

// Called when OTTA starts
void onStartOTA() {
	if (ArduinoOTA.getCommand() == U_FLASH) {						// Program update
		if (traceCode) {
			Serial.println("Starting firmware update");
		}
	} else { 														// File system uodate
		if (traceCode) {
			Serial.println("Starting file system update");
		}
		LittleFS.end();
	}
}
		
// Called when OTA ends
void onEndOTA() {
	if (traceCode) {
		Serial.println("End of update");
	}
}
	

// Called when OTA error occurs
void onErrorOTA(ota_error_t erreur) {
	Serial.print("OTA error(");
	Serial.print(erreur);
	Serial.print(") : Error ");
	if (erreur == OTA_AUTH_ERROR) {
		Serial.println("authentication");
	} else if (erreur == OTA_BEGIN_ERROR) {
		Serial.println("starting");
	} else if (erreur == OTA_CONNECT_ERROR) {
		Serial.println("connecting");
	} else if (erreur == OTA_RECEIVE_ERROR) {
		Serial.println("receiving");
	} else if (erreur == OTA_END_ERROR) {
		Serial.println("terminating");
	} else {
		Serial.println("unknown !");
	}
}

//	---- Start of program initialization code

void setup() {
	Serial.begin(74880);											// Init serial port to 74880 bds (~ 7.500 characters per second)
	Serial.println("Initializing...");

	// Starts flash file system
	LittleFS.begin();

	// Load preferences
	if (!readSettings()) {
		Serial.printf("No settings, stopping !\n");
		while (true) {
			yield();
		}
	};
	
	WiFi.hostname(espName.c_str());									// Defines this module name
	IPAddress adresseIP;											// Client or server IP address

	ssid.trim();
	if (ssid != "") {												// If SSID is given, try to connect to
		Serial.printf("\nConnect to %s ", ssid.c_str());

		uint16_t loopCount = 0;										// Tentative cound
		WiFi.begin(ssid.c_str(), pwd.c_str());						// Start to connect to existing SSID
		while (WiFi.status() != WL_CONNECTED && loopCount < 120) {	// Wait for connection or 120 loops (1 mn)
			delay(500);												// Wait for 0.5 s
			Serial.print(".");										// Display a dot
			loopCount++;
		}															// Loop
		adresseIP = WiFi.localIP();									// Client IP address
	}

	if (WiFi.status() != WL_CONNECTED) {							// If we're not connected
		char buffer[32];
		// Load this Wifi access point name as "PontTournant" plus ESP chip Id
		snprintf(buffer, sizeof(buffer),"PontTournant_%X", ESP.getChipId());
		Serial.printf("\nCreating %s access point\n", buffer);
		WiFi.softAP(buffer, "");									// Starts Wifi access point
		adresseIP = WiFi.softAPIP();								// Server IP address
	}

	Serial.println();
	Serial.print("Connect to http://");
	Serial.print(adresseIP);										// Display client or server IP address
	Serial.print("/ or http://");
	Serial.print(espName);
	Serial.println("/");
	
	// OTA trace
	ArduinoOTA.onStart(onStartOTA);
	ArduinoOTA.onEnd(onEndOTA);
	ArduinoOTA.onError(onErrorOTA);

	//ArduinoOTA.setPassword("my OTA password");					// Uncomment to set an OTA password
	ArduinoOTA.begin();												// Initialize OTA

	events.onConnect([](AsyncEventSourceClient *client){			// Routine called when a client connects
		float angle = encoder.computeAngle(resultValue);
		// Sends an "angle" events to connecting client
		char msg[10];
		if (enableEncoder) {
			snprintf_P(msg, sizeof(msg), PSTR("%.2f"), angle);
		} else {
			snprintf_P(msg, sizeof(msg), PSTR("%.2f"), currentAngle);
		}
		client->send(msg, "angle");
	});

    // List of URL to be intercepted and treated locally before a standard treatment
	//	These URL can be used as API
    webServer.on("/status", HTTP_GET, statusReceived);				// /status request
    webServer.on("/goto", HTTP_GET, gotoReceived);					// /goto request
	// These URL can be used in browser (in addition to /edit, managed in LittleFsEditor)
    webServer.on("/setup", HTTP_GET, setupReceived);				// /setup request
    webServer.on("/settings", HTTP_GET, settingsReceived);			// /settings request
    webServer.on("/debug", HTTP_GET, debugReceived);				// /debug request
	// These URL are used internally by setup.htm - Use them at your own risk!
    webServer.on("/pos", HTTP_GET, clickReceived);					// /pos request
    webServer.on("/move", HTTP_GET, moveReceived);					// /move request
    webServer.on("/imgref", HTTP_GET, imgRefReceived);				// /imgref request
    webServer.on("/changed", HTTP_GET, setChangedReceived);			// /changed request
    webServer.on("/setangle", HTTP_GET, setAngleReceived);			// /setangle request
    webServer.on("/tstsnd", HTTP_GET, testSoundReceived);			// /setangle request
	webServer.addHandler(&events);									// Define web events
	webServer.addHandler(new LittleFSEditor());						// Define file system editor
	webServer.onNotFound (notFound);								// To be called when URL is not known
	webServer.serveStatic("/",LittleFS, "/").setDefaultFile("index.htm"); // Serve "/", default page = index.htm
	webServer.begin();												// Start Web server

	stepper.begin();												// Stepper init

	digitalWrite(runPin, ledOnWhenHigh ? LOW: HIGH);				// Set rotation pin to OFF
	pinMode(runPin, OUTPUT);										// Set rotation pin to output mode
	
	mp3Player.set_storage(mp3Player.STORAGE_FLASH);					// Use files in flash (should be downloaded before using USB)
	mp3Player.set_play_mode(mp3Player.PLAY_TRACK_REPEAT);           // Repeat track forever

	encoder.setCallback(modbusCb);									// Modbus end request callback
	encoder.begin();												// Encoder init
    
    // Dcc setup
    memset(dccBuffer, 0, sizeof(dccBuffer));                        // Clear DCC buffer
}

// ---- Permanent loop ----
void loop() {
	// Manage stepper rotation
	StepperCommand::stepperPhases phase = stepper.stepperLoop();	// Run stepper loop
	if (rotationState == stepperRunning) {							// Are we rotating?
		if (phase == StepperCommand::phaseEnd) {					// At end of step?
			currentAngle = encoder.floatModuloPositive(				// Make result in range 0-360
				currentAngle + stepper.anglePerMicroStep()			// Update current angle
				, 360.0);
			microStepsToGo--;										// Remove one micro step
            if (microStepsToGo > inertiaEndStarting) {				// Are we in initial rotation?
                currentStepDuration -= inertiaDurationDecrement;	// Decrement duration
            } else if (microStepsToGo <= inertiaStepsStopping) {	// Are we in slowing down rotation?
                currentStepDuration += inertiaDurationIncrement;	// Increment duration
            } else {												// We are in full speed part
                currentStepDuration = normalStepDuration;			// Set normal duration
            }
			if (!microStepsToGo) {									// Do we end rotation?
				stopRotation();										// Stop rotation
			}
		} else if (phase == StepperCommand::phaseIdle) {			// Are we idle?
			stepper.turnOneMicroStep(currentStepDuration);			// Turn one micro step
		}
	} else if (rotationState == stepperStarting) {					// Are we starting?
		if ((millis() - playerStartedTime) > playerDuration) {		// Do we exhaust playing time?
			if (moveSoundIndex) {									// Do we have a rotation sound?
				playIndex(moveSoundIndex, moveSoundVolume);			// Play rotation sound
			} else {
				playStop();											// Stop starting sound
			}
			rotationState = stepperRunning;							// We're now running
			rotationStartTime = millis();							// Set start rotation time
		}
	} else if (rotationState == stepperStopping) {					// Are we stopping?
		if ((millis() - playerStartedTime) > playerDuration) {		// Do we exhaust playing time?
			playStop();												// Stop stopping sound
			rotationState = stepperStopped;							// Set state to stopped
        	digitalWrite(runPin, ledOnWhenHigh ? LOW: HIGH);		// Set rotation pin to OFF
		}
	} else if (rotationState == stepperFixing) {					// Are we fixing?
		if (phase == StepperCommand::phaseEnd) {					// At end of step?
			currentAngle = encoder.floatModuloPositive(				// Make result in range 0-360
				currentAngle + stepper.anglePerMicroStep()			// Update current angle
				, 360.0);
			microStepsToGo--;										// Remove one micro step
			if (!microStepsToGo) {									// Do we end rotation?
				rotationState = stepperStopped;						// Set state back to stoppeD
			}
		} else if (phase == StepperCommand::phaseIdle) {			// Are we idle?
			stepper.turnOneMicroStep(inertiaFinalStepDuration);		// Turn one micro step at slow speed
		}
	} else if (rotationState == stepperStopped) {					// Are we stopped?
		if (adjustPosition) {										// Is Position fixing enabled
			fixPosition();											// Fix position
		}
	} else if (rotationState == testingSound) {						// Are we testing sound?
		if ((millis() - playerStartedTime) > playerDuration) {		// Do we exhaust playing time?
			playStop();												// Stop playing sound
			rotationState = stepperStopped;							// We're now stopped
		}
	}

	// Manage encoder
	if (enableEncoder) {
		if (encoder.active()){										// Is encoder active?
			encoder.loop();											// Give habd to encoder
		}
	}
	
	if (enableEncoder) {											// Encoder enabled?
		if ((millis() - encoderReadTime) > 1000) {					// Last reading more than a second?
			encoderReading = true;									// Encoder reading
			encoderReadTime = millis();								// Read start time
			encoder.getAngle(&resultValue);							// Restart request
		}
	}

	if ((millis() - resultValueTime) > 1000) {						// Last result sent more than 1 s?
		if (abs(currentAngle - lastAngleSent) >= MIN_DELTA_ANGLE) {	// Send message only if there's a slight difference
			// Sends an "angle" event to browser
			char msg[10];											// Message buffer
			snprintf_P(msg, sizeof(msg), PSTR("%.2f"), currentAngle); // Convert angle to message
			events.send(msg, "angle");								// Send an "angle" message
			lastAngleSent = currentAngle;							// Save last angle sent
		}
		resultValueTime = millis();									// Save time of last result
	}

    if (enableDCC) {                                                // If DCC is enabled
        checkForDccMessage();
    }

	ArduinoOTA.handle();											// Give hand to OTA
}
