FlyingDomotic/Railway-turntable/src/littleFsEditor.h

#ifndef LittleFSEditor_H_
#define LittleFSEditor_H_
#include <ESPAsyncWebServer.h>
#include <LittleFS.h>										// Gestion du système de fichier

class LittleFSEditor: public AsyncWebHandler {
  private:
    fs::FS _fs;
    String _username;
    String _password; 
    bool _authenticated;
    uint32_t _startTime;
  public:
#ifdef ESP32
    LittleFSEditor(const fs::FS& fs, const String& username=String(), const String& password=String());
#else
    LittleFSEditor(const String& username=String(), const String& password=String(), const fs::FS& fs=LittleFS);
#endif
    virtual bool canHandle(AsyncWebServerRequest *request) override final;
    virtual void handleRequest(AsyncWebServerRequest *request) override final;
    virtual void handleUpload(AsyncWebServerRequest *request, const String& filename, size_t index, uint8_t *data, size_t len, bool final) override final;
    virtual bool isRequestHandlerTrivial() override final {return false;}
};

#endif
