FlyingDomotic/Railway-turntable/(commit log)

2024-05-18 Add stepper reduction
    [D1 mini pin-out.xlsx]
2024-05-20 Add turntable and encoder rotation preferences
2024-05-29 Change MP3 module to DFPlayer Mini MP3 Player
    [D1 mini pin-out.xlsx]
2024-06-07 Change PIN assignment
    [D1 mini pin-out.xlsx]
2024-06-09 Add buttons to test sounds
2024-06-11 Reduce a bit trace information
    This reduces also event traffic, and allow smoother turntable update in browser
2024-06-24 Remove some traces
2024-06-30 Fix files and add schema
    [PontTournant.ino, preferences.h, rotationSensor.cpp, stepperCommand.cpp]
2024-07-15 Change MP3 player to DS-SV17A, change pinout
    [D1 mini pin-out.xlsx]
2024-07-25 Change LED to D2. Some cosmetic changes
2024-10-10 Add a 220 pF capacitor on rails side
2024-10-25 Implement DCC decoder on an External Arduino
    Due to high level of interrupts generated by DCC signal (with permanent idle messages), an Arduino has been added to filter all but accessories messages, leading to a stable platform.
2024-12-02 Allow locomotive flipping on DCC
    [PontTournant.ino, preferences.h]
